EGHFran/smart-air-node-lora-temuco/hardware/NodoEmisor.png

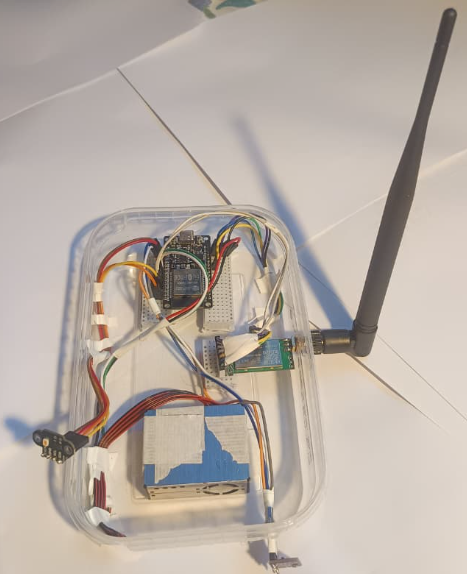
hardware/NodoEmisor.png
