EGHFran/smart-air-node-lora-temuco/hardware/NodoReceptor1.jpeg

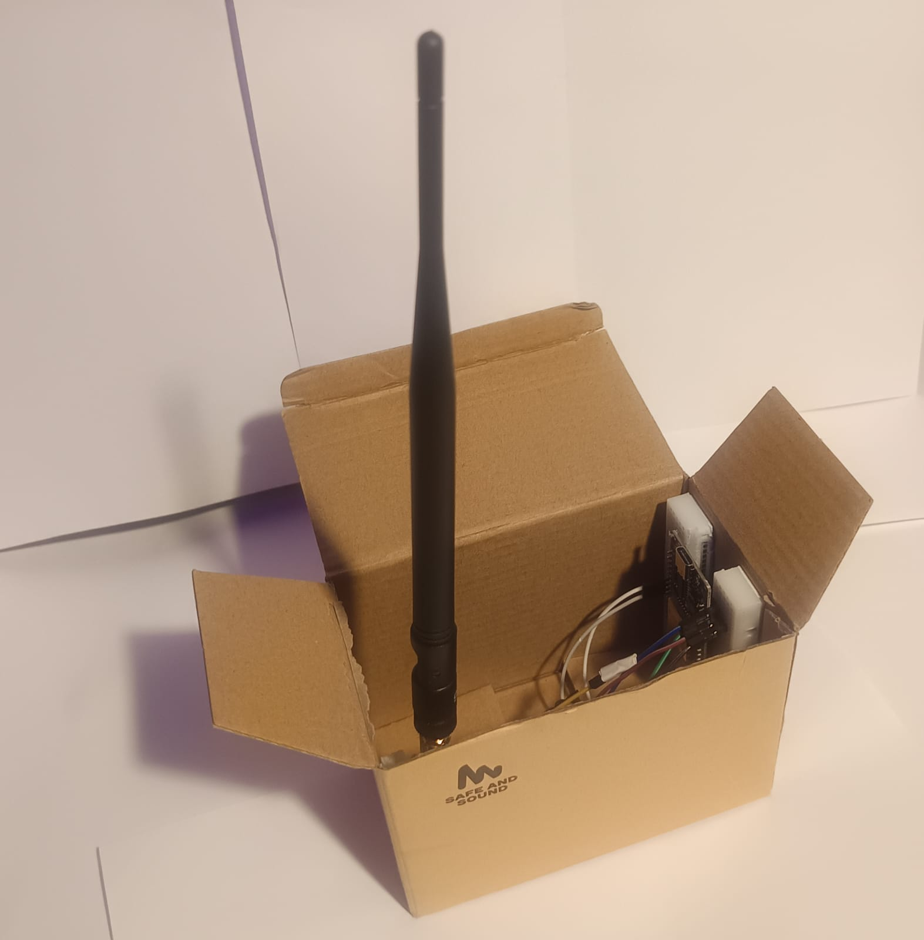
hardware/NodoReceptor1.jpeg
