EGHFran/smart-air-node-lora-temuco/docs/CorreoProfesorCompraImplementos/Preguntas.png

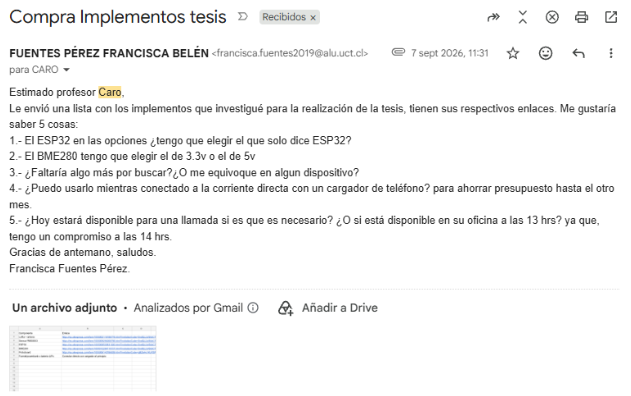
docs/CorreoProfesorCompraImplementos/Preguntas.png
