EGHFran/smart-air-node-lora-temuco/docs/CorreoProfesorCompraImplementos/Respuestas.png

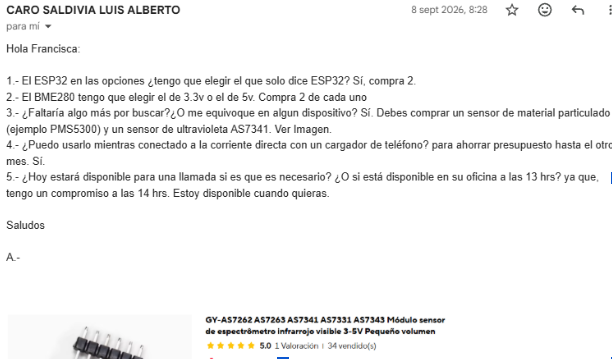
docs/CorreoProfesorCompraImplementos/Respuestas.png
