EGHFran/smart-air-node-lora-temuco/docs/Rubrica_Etapa_2.png

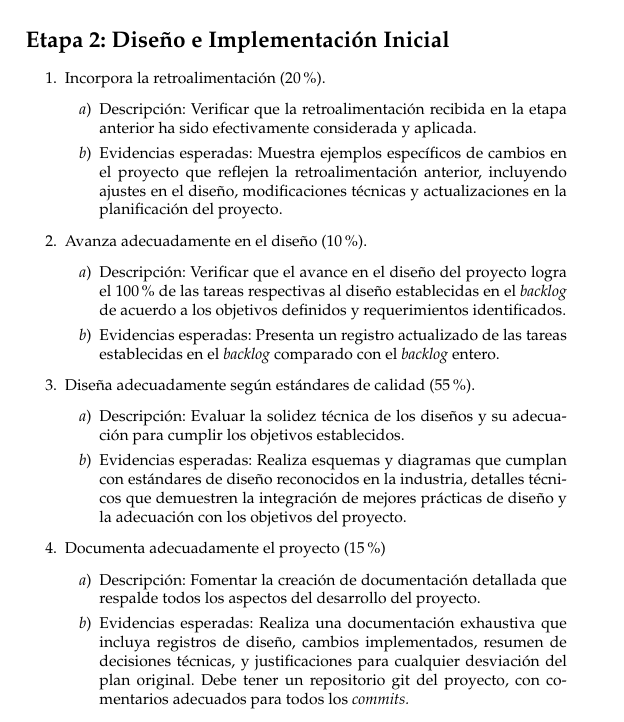
docs/Rubrica_Etapa_2.png
