EGHFran/smart-air-node-lora-temuco/hardware/fimwareReceptor.drawio.png

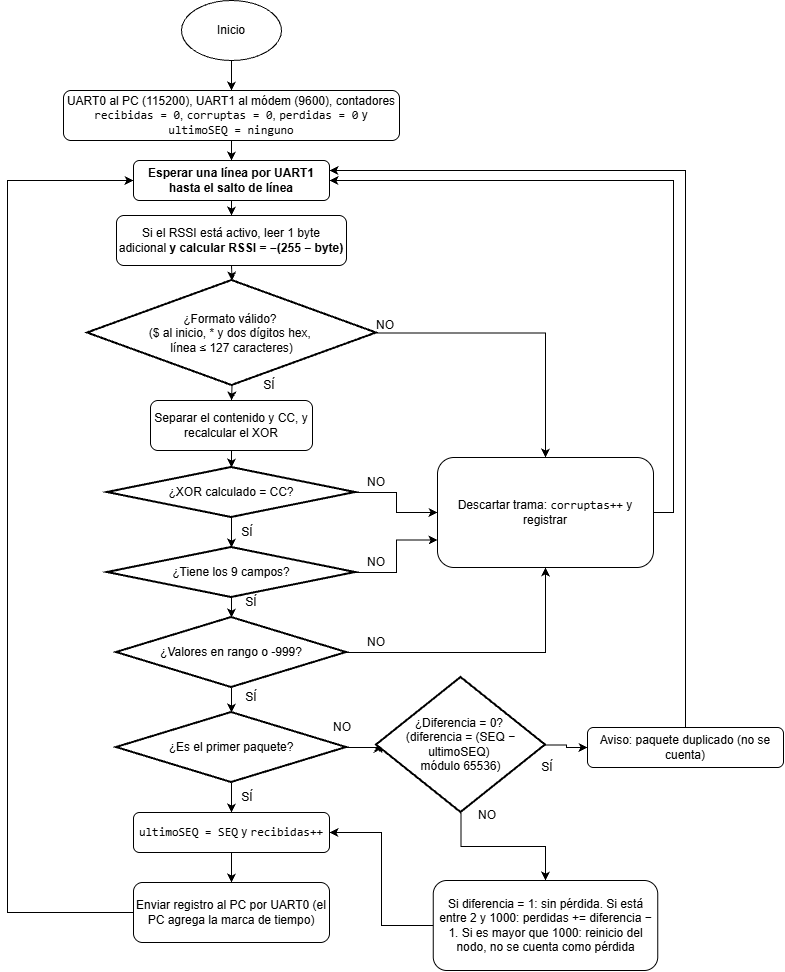
hardware/fimwareReceptor.drawio.png
