EGHFran/smart-air-node-lora-temuco/hardware/firmwareEmisor.drawio.png

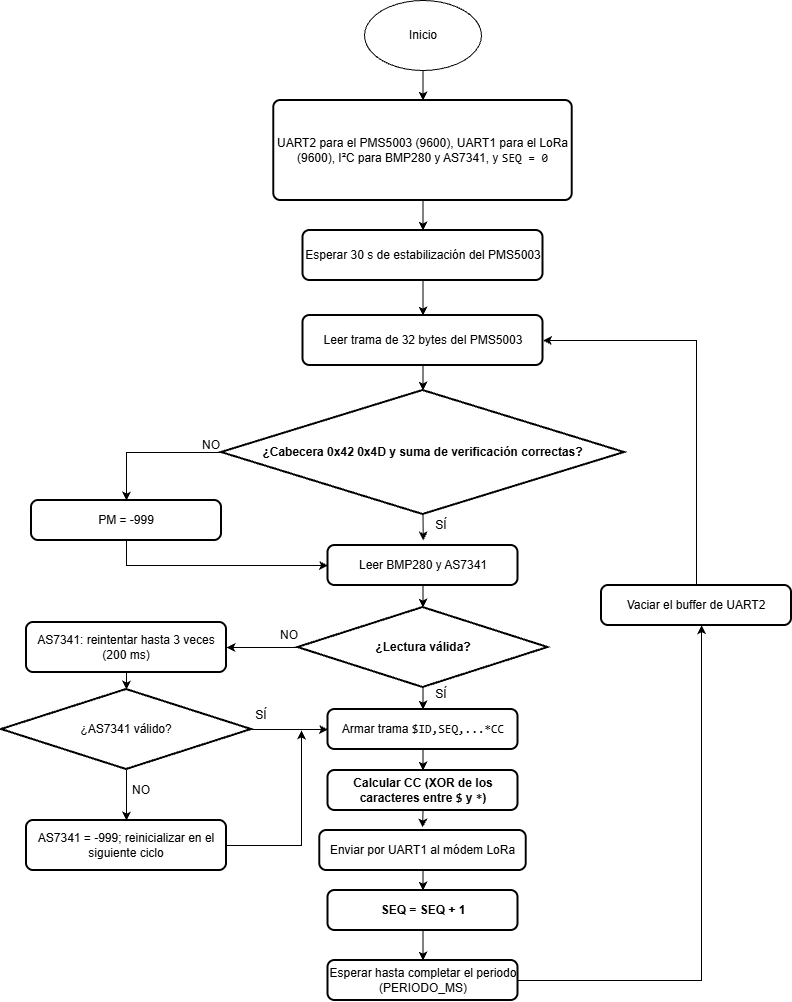
hardware/firmwareEmisor.drawio.png
