EGHFran/smart-air-node-lora-temuco/hardware/NodoReceptor2.jpeg

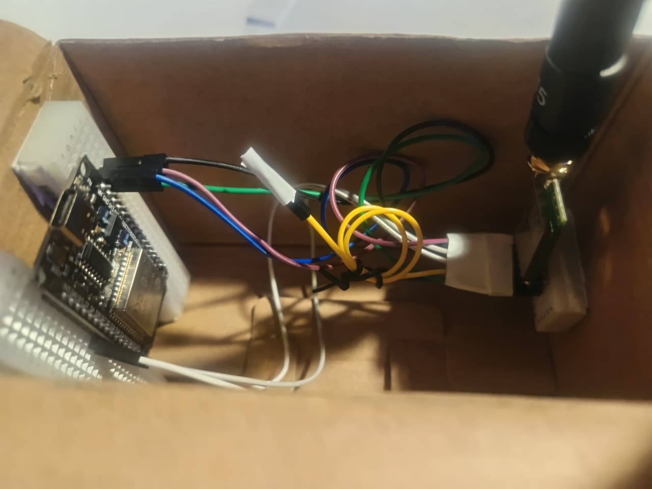
hardware/NodoReceptor2.jpeg
