EGHFran/smart-air-node-lora-temuco/tests/checksumtest/eventos_20261018_230937.csv

timestamp | tipo | detalle
2026-10-18T23:09:37-03:00 | INFO | puerto COM5 abierto
2026-10-18T23:10:21-03:00 | ERR | checksum | $N01,1,103,194,226,23.5,999.3,-999,713*58
2026-10-18T23:12:01-03:00 | ERR | checksum | $N01,00,96,183,215,23.2,999.3,-999,701*56
2026-10-18T23:13:42-03:00 | ERR | checksum | $N01,30,69,123,138,22.9,999.3,-999,0*5F
2026-10-18T23:15:21-03:00 | ERR | checksum | $N01,20,80,153,173,23.4,999.3,-999,0*5D
2026-10-18T23:17:01-03:00 | ERR | checksum | $N01,50,70,133,152,23.4,999.3,-999,0*50
2026-10-18T23:18:41-03:00 | ERR | checksum | $N01,40,65,119,144,23.1,999.4,-999,0*58
2026-10-18T23:20:21-03:00 | ERR | checksum | $N01,70,53,98,116,22.9,999.4,-999,0*68
2026-10-18T23:22:02-03:00 | ERR | checksum | $N01,60,67,121,139,23.0,999.4,-999,0*58
2026-10-18T23:23:41-03:00 | ERR | checksum | $N01,90,55,97,117,23.1,999.4,-999,0*67
2026-10-18T23:25:21-03:00 | ERR | checksum | $N01,80,65,120,140,23.4,999.3,-999,1*59
2026-10-18T23:27:01-03:00 | ERR | checksum | $N01,000,49,87,97,23.2,999.2,-999,0*6E
2026-10-18T23:28:41-03:00 | ERR | checksum | $N01,010,53,95,108,23.4,999.2,-999,0*56
2026-10-18T23:30:21-03:00 | ERR | checksum | $N01,020,50,95,109,23.2,999.2,-999,0*51
