EGHFran/smart-air-node-lora-temuco/tests/checksumtest/eventos_20261019_103044.csv

timestamp | tipo | detalle
2026-10-19T10:30:44-03:00 | INFO | puerto COM6 abierto
2026-10-19T10:31:01-03:00 | ERR | checksum | $N01,70,7,14,15,20.7,997.5,-999,85*51
2026-10-19T10:31:51-03:00 | ERR | checksum | $N01,60,8,12,13,20.7,997.5,-999,85*5F
2026-10-19T10:32:40-03:00 | ERR | checksum | $N01,90,7,13,15,20.7,997.5,-999,84*59
2026-10-19T10:33:31-03:00 | ERR | checksum | $N01,80,7,11,14,20.7,997.5,-999,85*5A
2026-10-19T10:34:21-03:00 | ERR | checksum | $N01,000,8,12,12,20.7,997.6,-999,85*6B
2026-10-19T10:35:11-03:00 | ERR | checksum | $N01,010,8,13,16,20.7,997.6,-999,85*6F
2026-10-19T10:36:01-03:00 | ERR | checksum | $N01,020,6,10,10,20.7,997.6,-999,85*67
2026-10-19T10:36:51-03:00 | ERR | checksum | $N01,030,7,12,14,20.7,997.5,-999,85*62
2026-10-19T10:37:41-03:00 | ERR | checksum | $N01,040,6,10,12,20.7,997.5,-999,85*60
2026-10-19T10:38:31-03:00 | ERR | checksum | $N01,050,6,10,13,20.7,997.5,-999,85*60
2026-10-19T10:39:21-03:00 | ERR | checksum | $N01,060,5,8,8,20.7,997.6,-999,84*61
2026-10-19T10:40:11-03:00 | ERR | checksum | $N01,070,5,11,14,20.8,997.6,-999,85*6B
2026-10-19T10:41:01-03:00 | ERR | checksum | $N01,080,9,12,17,20.8,997.6,-999,85*68
2026-10-19T10:41:51-03:00 | ERR | checksum | $N01,090,6,10,12,20.8,997.6,-999,85*61
2026-10-19T10:42:41-03:00 | ERR | checksum | $N01,300,4,8,11,20.8,997.6,-999,85*53
