EGHFran/smart-air-node-lora-temuco/tests/checksumtest/lecturas_20261019_103044.csv

timestamp | nodo_id | seq | pm1_0 | pm2_5 | pm10 | temperatura | presion | humedad | luz_f5 | rssi | snr | recibidas | corruptas | perdidas
2026-10-19T10:30:46-03:00 | N01 | 57 | 8 | 13 | 15 | 20.7 | 997.5 |  | 85 |  |  | 7 | 1 | 0
2026-10-19T10:30:51-03:00 | N01 | 58 | 8 | 12 | 13 | 20.7 | 997.5 |  | 85 |  |  | 8 | 1 | 0
2026-10-19T10:30:56-03:00 | N01 | 59 | 9 | 15 | 16 | 20.7 | 997.5 |  | 85 |  |  | 9 | 1 | 0
2026-10-19T10:31:06-03:00 | N01 | 61 | 7 | 14 | 14 | 20.7 | 997.5 |  | 85 |  |  | 10 | 2 | 1
2026-10-19T10:31:11-03:00 | N01 | 62 | 7 | 13 | 13 | 20.7 | 997.6 |  | 85 |  |  | 11 | 2 | 1
2026-10-19T10:31:16-03:00 | N01 | 63 | 8 | 13 | 15 | 20.7 | 997.5 |  | 85 |  |  | 12 | 2 | 1
2026-10-19T10:31:21-03:00 | N01 | 64 | 8 | 12 | 15 | 20.7 | 997.5 |  | 85 |  |  | 13 | 2 | 1
2026-10-19T10:31:26-03:00 | N01 | 65 | 8 | 12 | 14 | 20.7 | 997.5 |  | 85 |  |  | 14 | 2 | 1
2026-10-19T10:31:31-03:00 | N01 | 66 | 8 | 12 | 14 | 20.7 | 997.5 |  | 85 |  |  | 15 | 2 | 1
2026-10-19T10:31:36-03:00 | N01 | 67 | 8 | 12 | 14 | 20.7 | 997.5 |  | 85 |  |  | 16 | 2 | 1
2026-10-19T10:31:41-03:00 | N01 | 68 | 8 | 11 | 13 | 20.7 | 997.5 |  | 85 |  |  | 17 | 2 | 1
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
