EGHFran/smart-air-node-lora-temuco/tests/eventos_20261017_221425.csv

timestamp | tipo | detalle
2026-10-17T22:14:25-03:00 | INFO | puerto COM5 abierto
2026-10-17T22:18:14-03:00 | INFO | puerto desconectado
