EGHFran/smart-air-node-lora-temuco/tests/eventos_20261017_223041.csv

timestamp | tipo | detalle
2026-10-17T22:30:41-03:00 | INFO | puerto COM5 abierto
