EGHFran/smart-air-node-lora-temuco/hardware/DOC-TEC-01_Esquematico_Nodo_Emisor.PDF

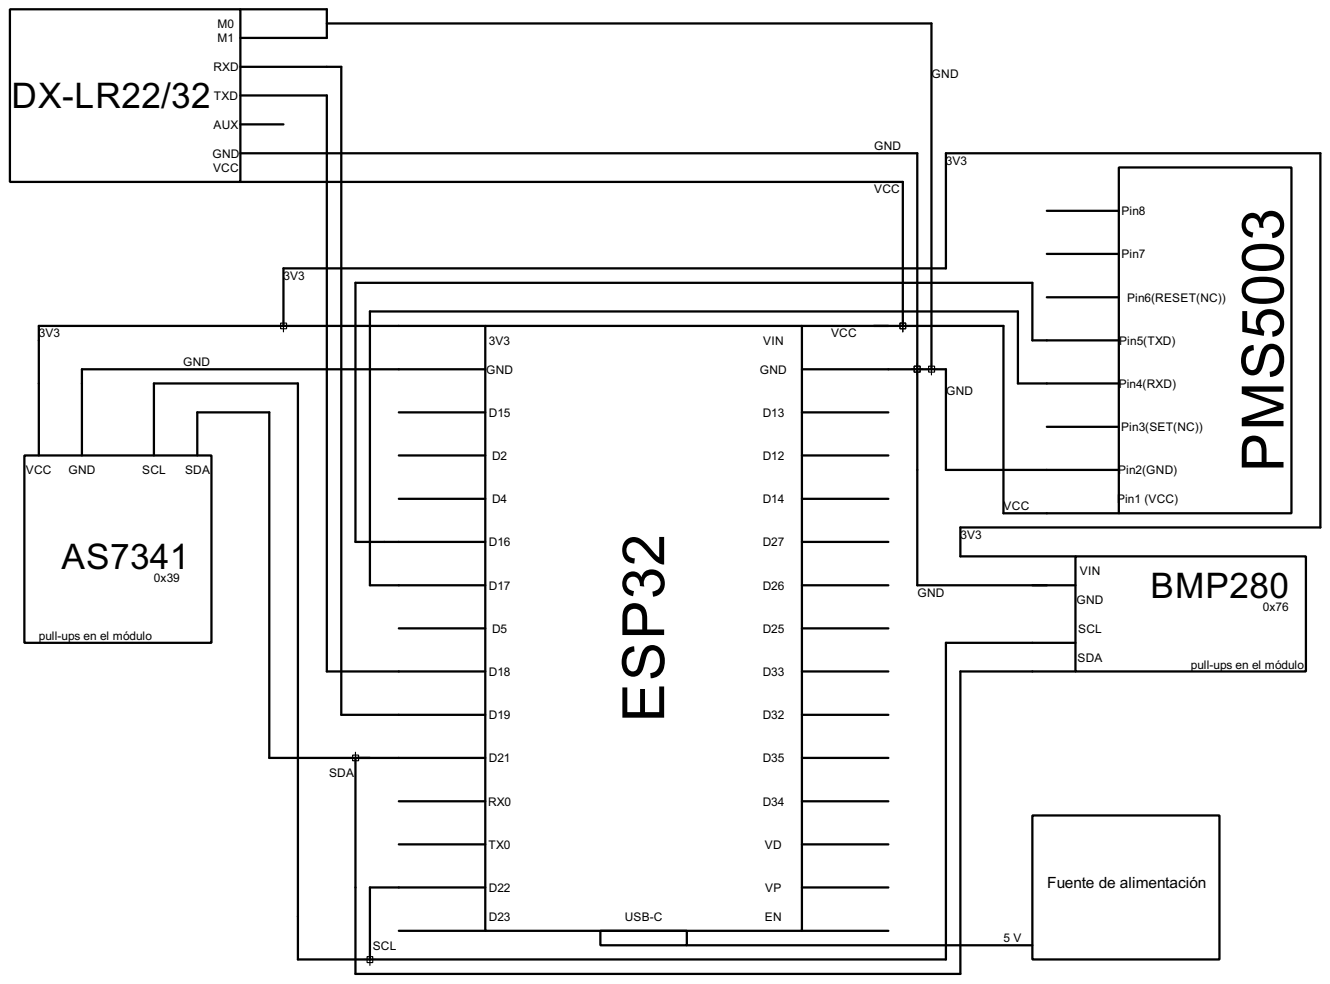
[picture p9: page 1]

ESP32 PMS5003 Pin1 (VCC) Pin2(GND) Pin3(SET(NC)) Pin4(RXD) Pin5(TXD) Pin6(RESET(NC)) VIN GND Pin7 Pin8 3V3 GND D15 D2D4 D16 D17 D5 D18 D19 D21 RX0 TX0 D22 D23 D13 D14 D12 D27 D26 D25 D33 D35 D34 VP D32 VDEN BMP280 VIN GND SCL SDA VCC GND SCL SDA AS7341 VCC GND AUX TXD RXD M1 M0 DX-LR22/32 USB-C pull-ups en el módulo pull-ups en el módulo GND GND GND GND GND VCC VCC VCC 3V3 3V3 3V3 3V3 SDA SCL 0x76 0x39 Fuente de alimentación 5 V
