EGHFran/smart-air-node-lora-temuco/hardware/DOC-TEC-01_Esquematico_Nodo_Receptor.PDF

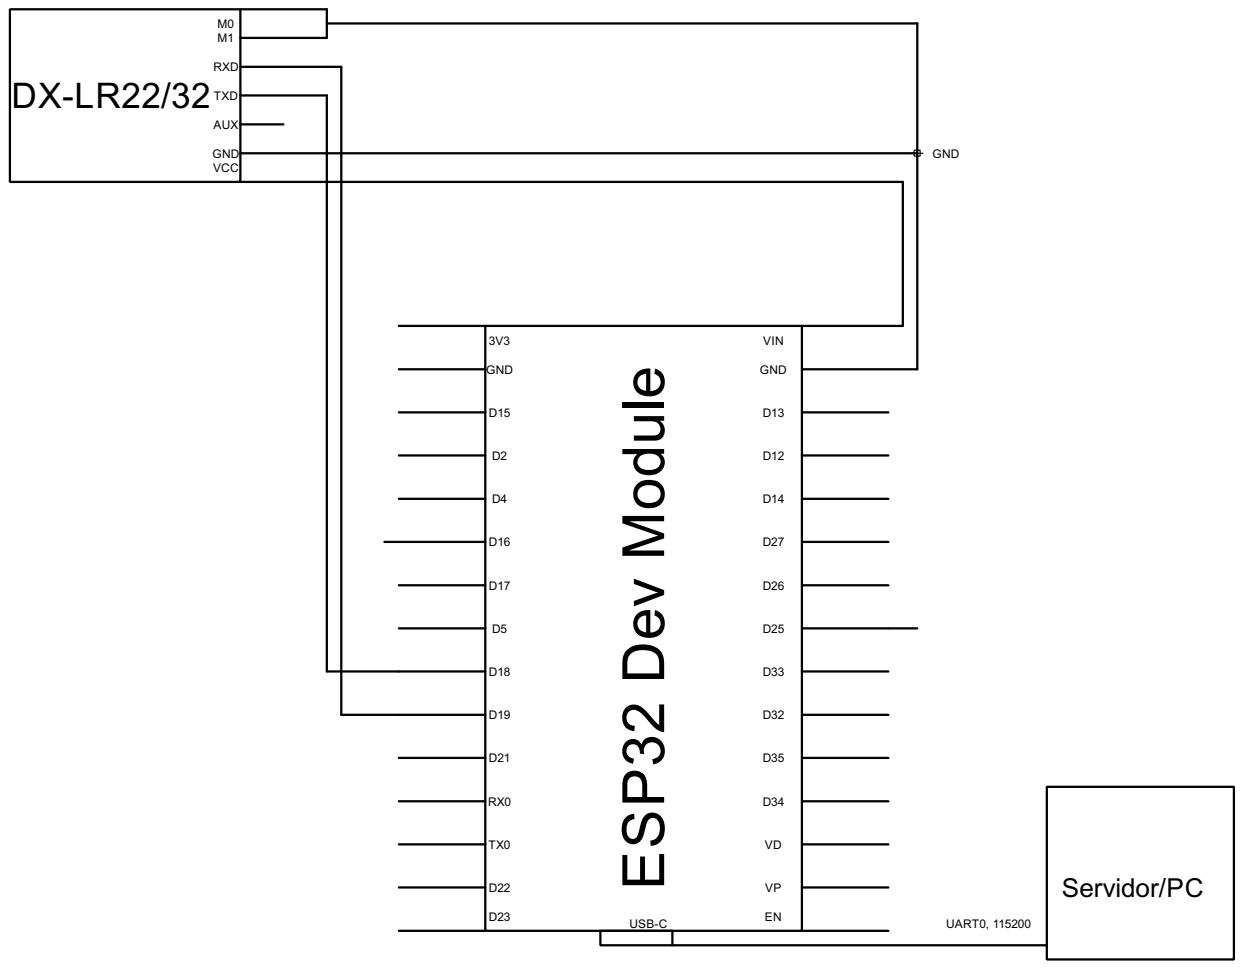
[picture p10: page 1]

ESP32 Dev Module VIN GND 3V3 GND D15 D2D4 D16 D17 D5 D18 D19 D21 RX0 TX0 D22 D23 D13 D14 D12 D27 D26 D25 D33 D35 D34 VP D32 VDEN VCC GND AUX TXD RXD M1 M0 DX-LR22/32 GND USB-C Servidor/PC UART0, 115200
