EGHFran/smart-air-node-lora-temuco/(commit log)

2026-10-09 Agregar hojas de datos (datasheets) de los componentes del nodo y LoRa. Agregar firmware para emisor y receptor LoRa con sensores ambientales, particulados y espectrales
2026-10-19 feat(receptor): firmware de la estacion base con validacion de trama y calculo de perdidas por SEQ
2026-10-19 feat(pc): agregar registrador.py con marca de tiempo y registro en CSV
2026-10-19 chore(lora): agregar sketch de intentos de configuracion AT del modem (I-02)
2026-10-19 test: agregar registros de P-02 y P-04a (CSV de lecturas y eventos)
2026-10-19 docs(hardware): agregar esquematicos, diagramas de flujo y fotos del montaje
2026-10-19 docs: agregar informe de la etapa 2, rubrica y correo del profesor guia
2026-10-19 test(checksum): organizar prueba de inyeccion de error XOR en subcarpeta checksumtest
2026-10-27 Agrega Grafana (Docker) y dashboard de calidad del aire
2026-10-28 Se suben archivos de texto de las tramas corruptas de los tessts
2026-10-30 feat: inicializar estructura base de la API y dependencias
2026-10-30 Creacion del MVP de la aplicacion en react, tanto el panel de administrador como el panel de usuarios
2026-11-08 feat(web): actualizar panel de administracion en React
2026-11-08 feat(api): mover env.example a la raiz y actualizar dependencias
2026-11-08 feat(tools): implementar modulo independiente de alertas por Telegram
2026-11-08 feat(ml): agregar estructura base para modelos de prediccion
